nmalamug/HandsFreeBikeLight/images/BikeLightBrightnessCalculations.jpg

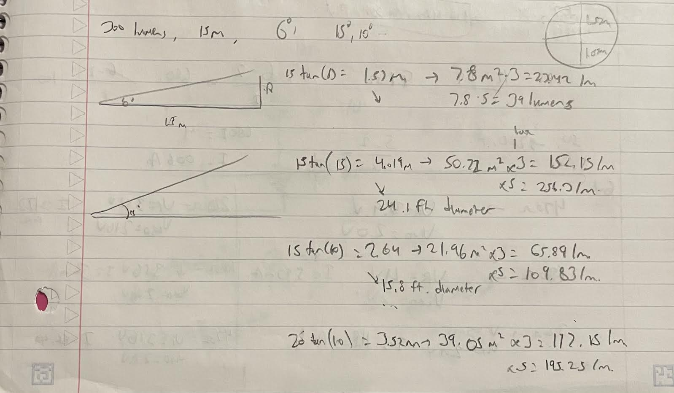
images/BikeLightBrightnessCalculations.jpg
