nmalamug/HandsFreeBikeLight/images/BikeLightStreetLightCalculations.jpg

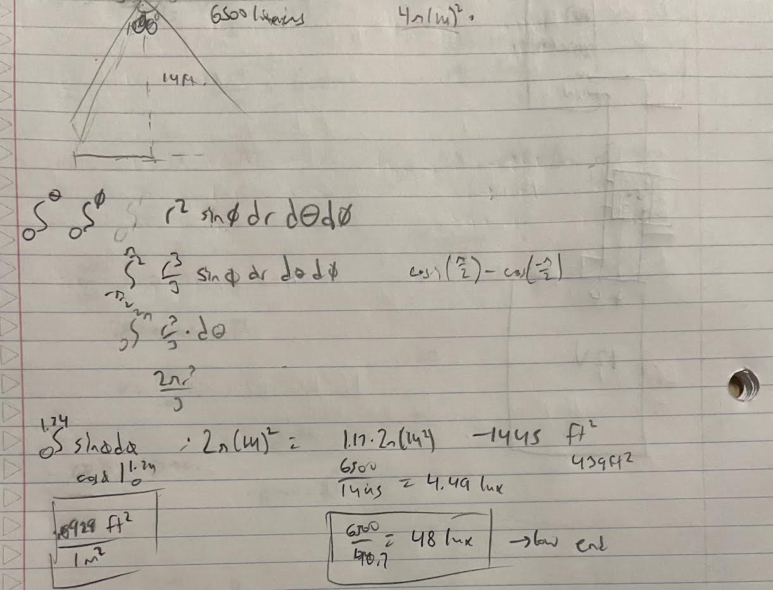
images/BikeLightStreetLightCalculations.jpg
